gioda954/Robotics_hand/docs/media/README.md

# Media Assets

Portfolio media files used by `docs/portfolio.md`.

Current PCB assets:

- `pcb-system-block-diagram.png` - electrical block diagram for power, motor drivers, sensors, and MCU interfaces.
- `pcb-3d-render.png` - rendered view of the assembled controller PCB.
- `pcb-routing-layout.png` - PCB layout and routing view.

Recommended remaining files:

- `assembled-hand.jpg` showing the completed robotic hand.
- `demo-video-url.txt` or a Markdown link to a hosted demonstration video.
- `rework-photos/` for any board or mechanical rework images.
