gioda954/Robotics_hand/(commit log)

2026-06-15 Create CAD
2026-06-15 Add PCB design details to portfolio
2026-06-15 Replace media attachments with final demo video
