gioda954/Robotics_hand/(notices)

Notices in the files:
Codebase/Core/Src/main.c:
Copyright (c) 2026 STMicroelectronics.
All rights reserved.
This software is licensed under terms that can be found in the LICENSE file
